RWeick/Gameboy-Demo-Kiosk-DemoBoy-II-/Pics and Documentation/Gameboy Mainboard Connections.jpg

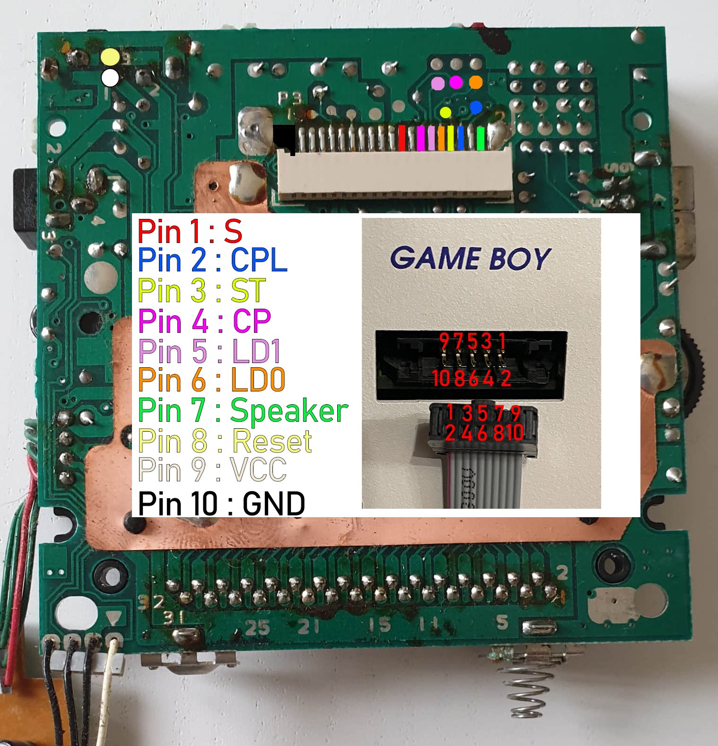
Pics and Documentation/Gameboy Mainboard Connections.jpg
