RWeick/Gameboy-Demo-Kiosk-DemoBoy-II-/Pics and Documentation/Demo_BoyII_Manual.JPG

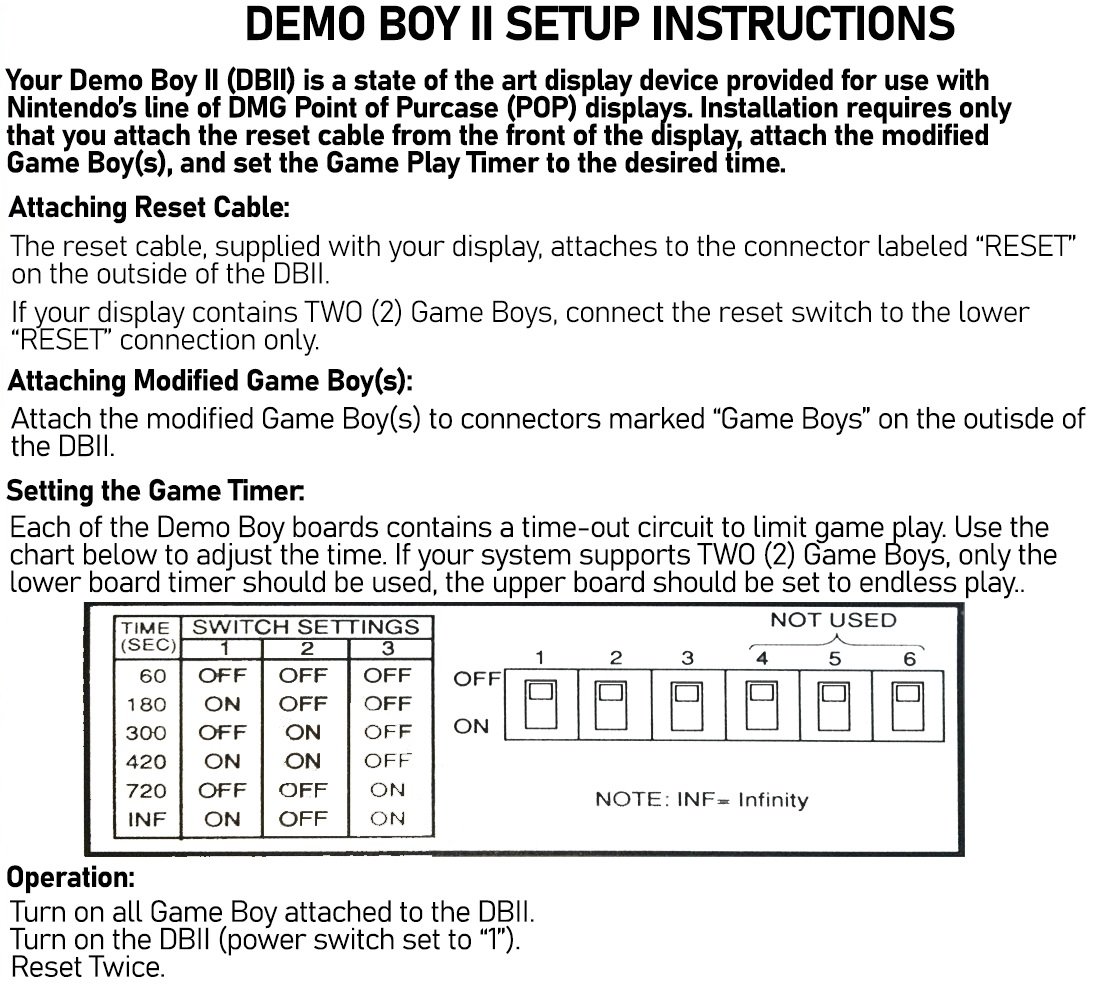
Pics and Documentation/Demo_BoyII_Manual.JPG
