RWeick/Gameboy-Demo-Kiosk-DemoBoy-II-/DemoBoy.kicad_sch

## KiCad design DemoBoy.kicad_sch (2025-12-26)

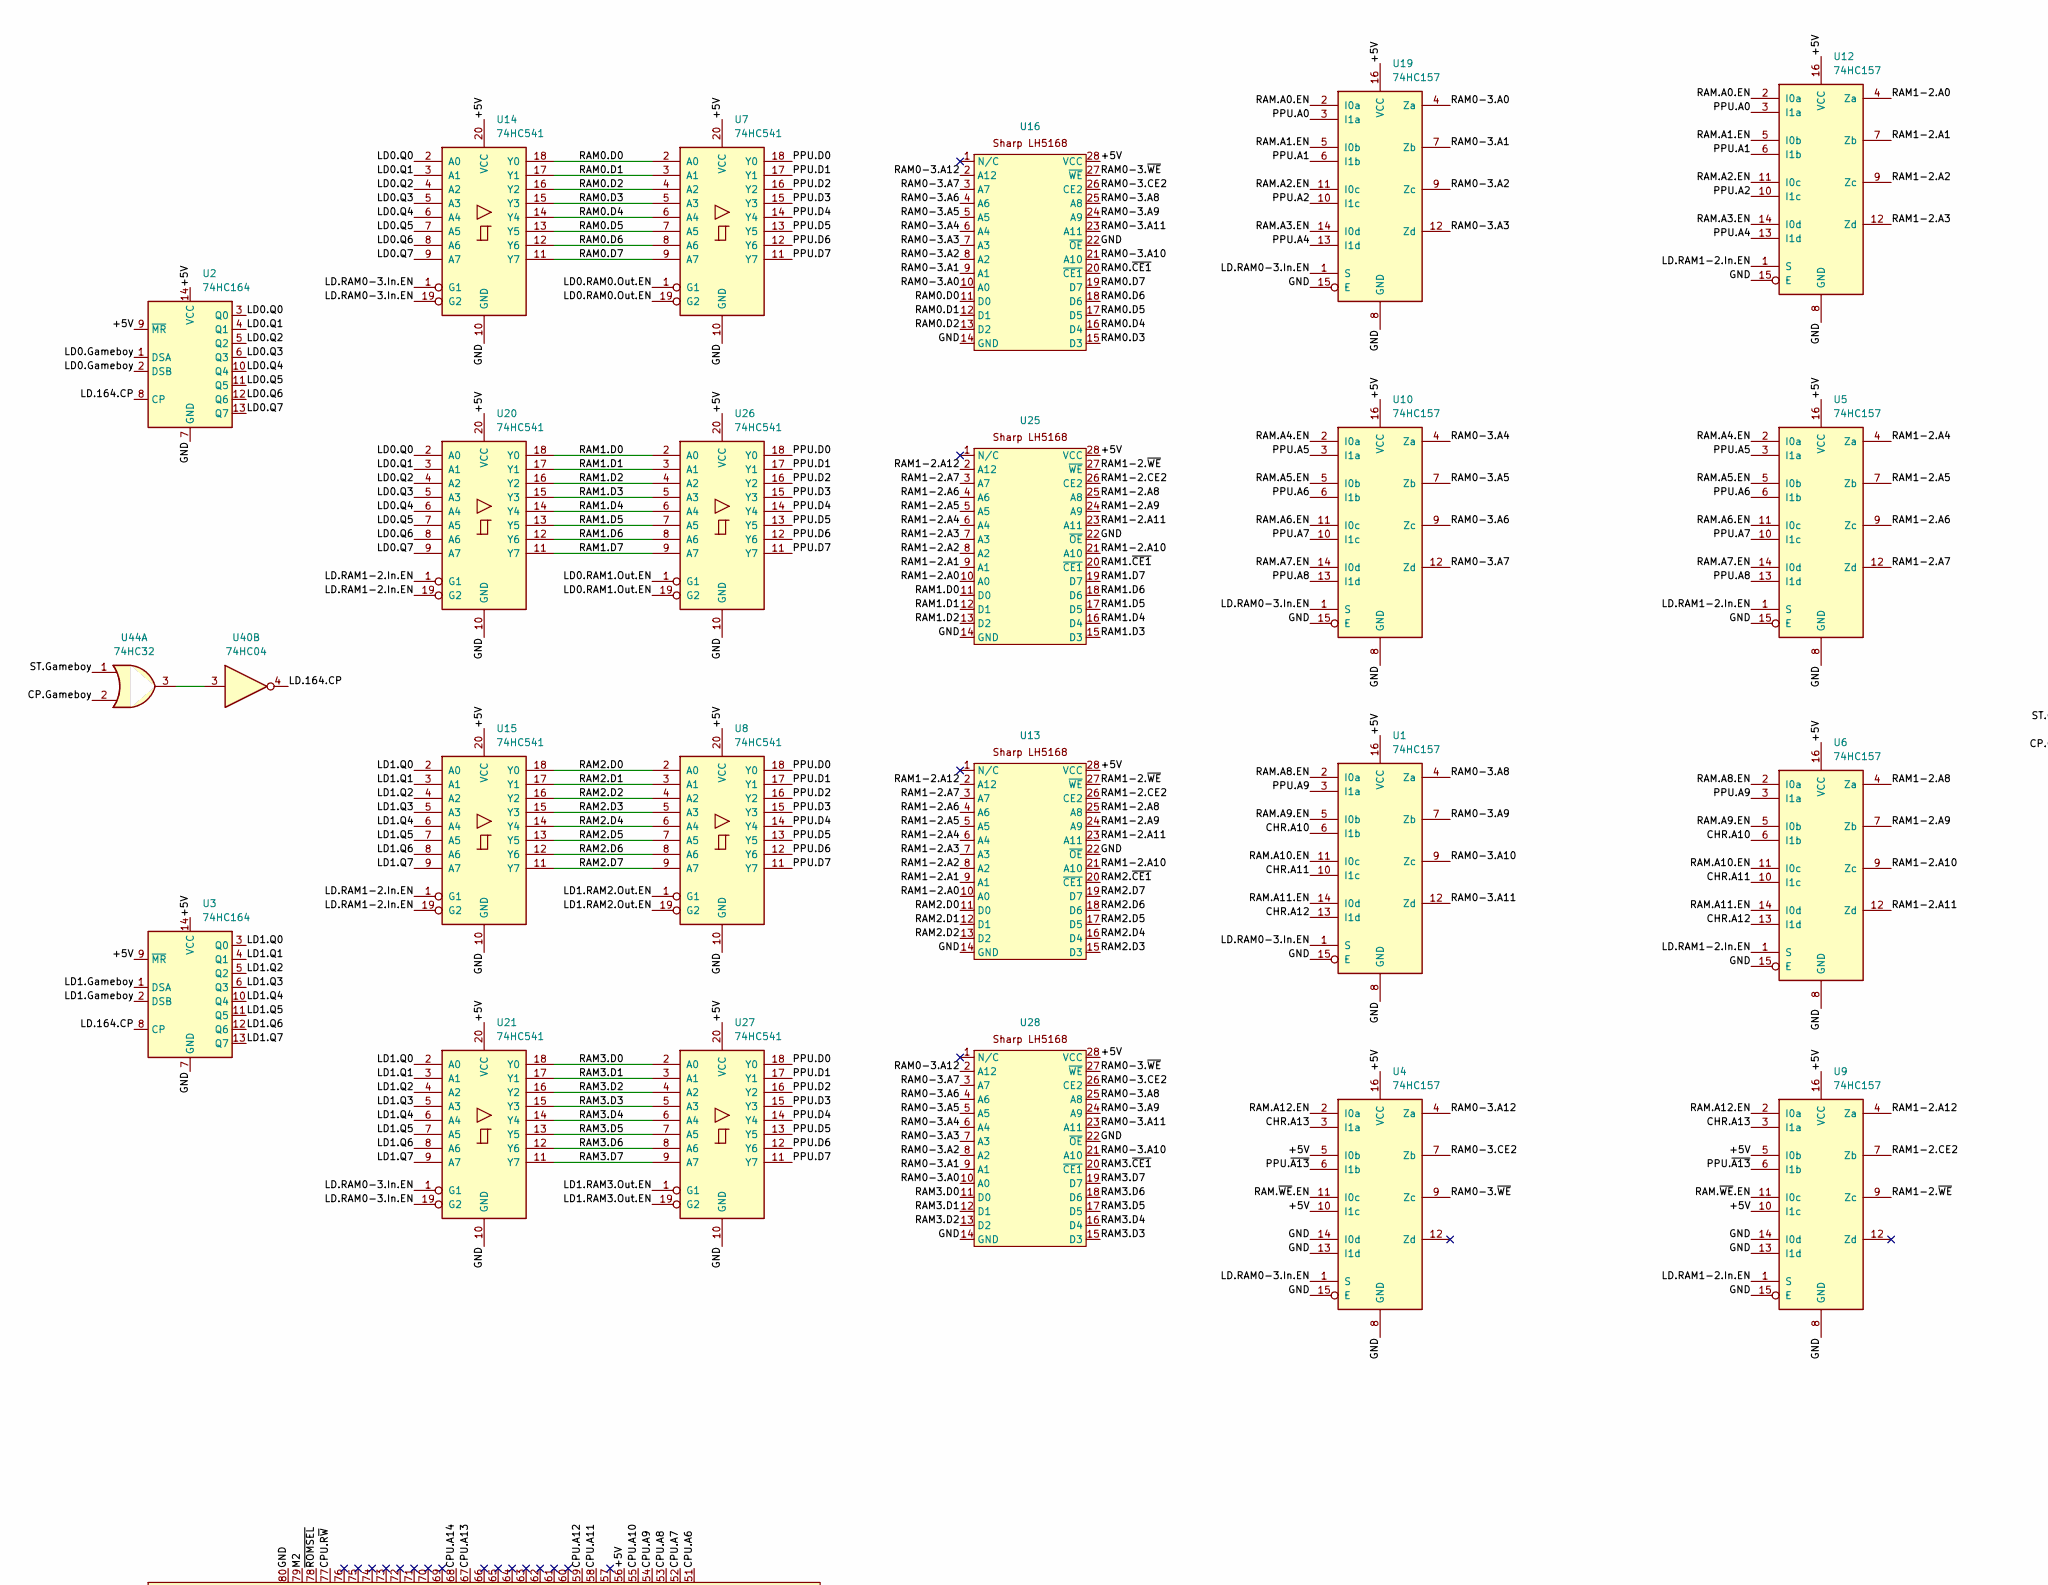
[picture p4: schematic DemoBoy.kicad_sch, part in row 1, column 1]

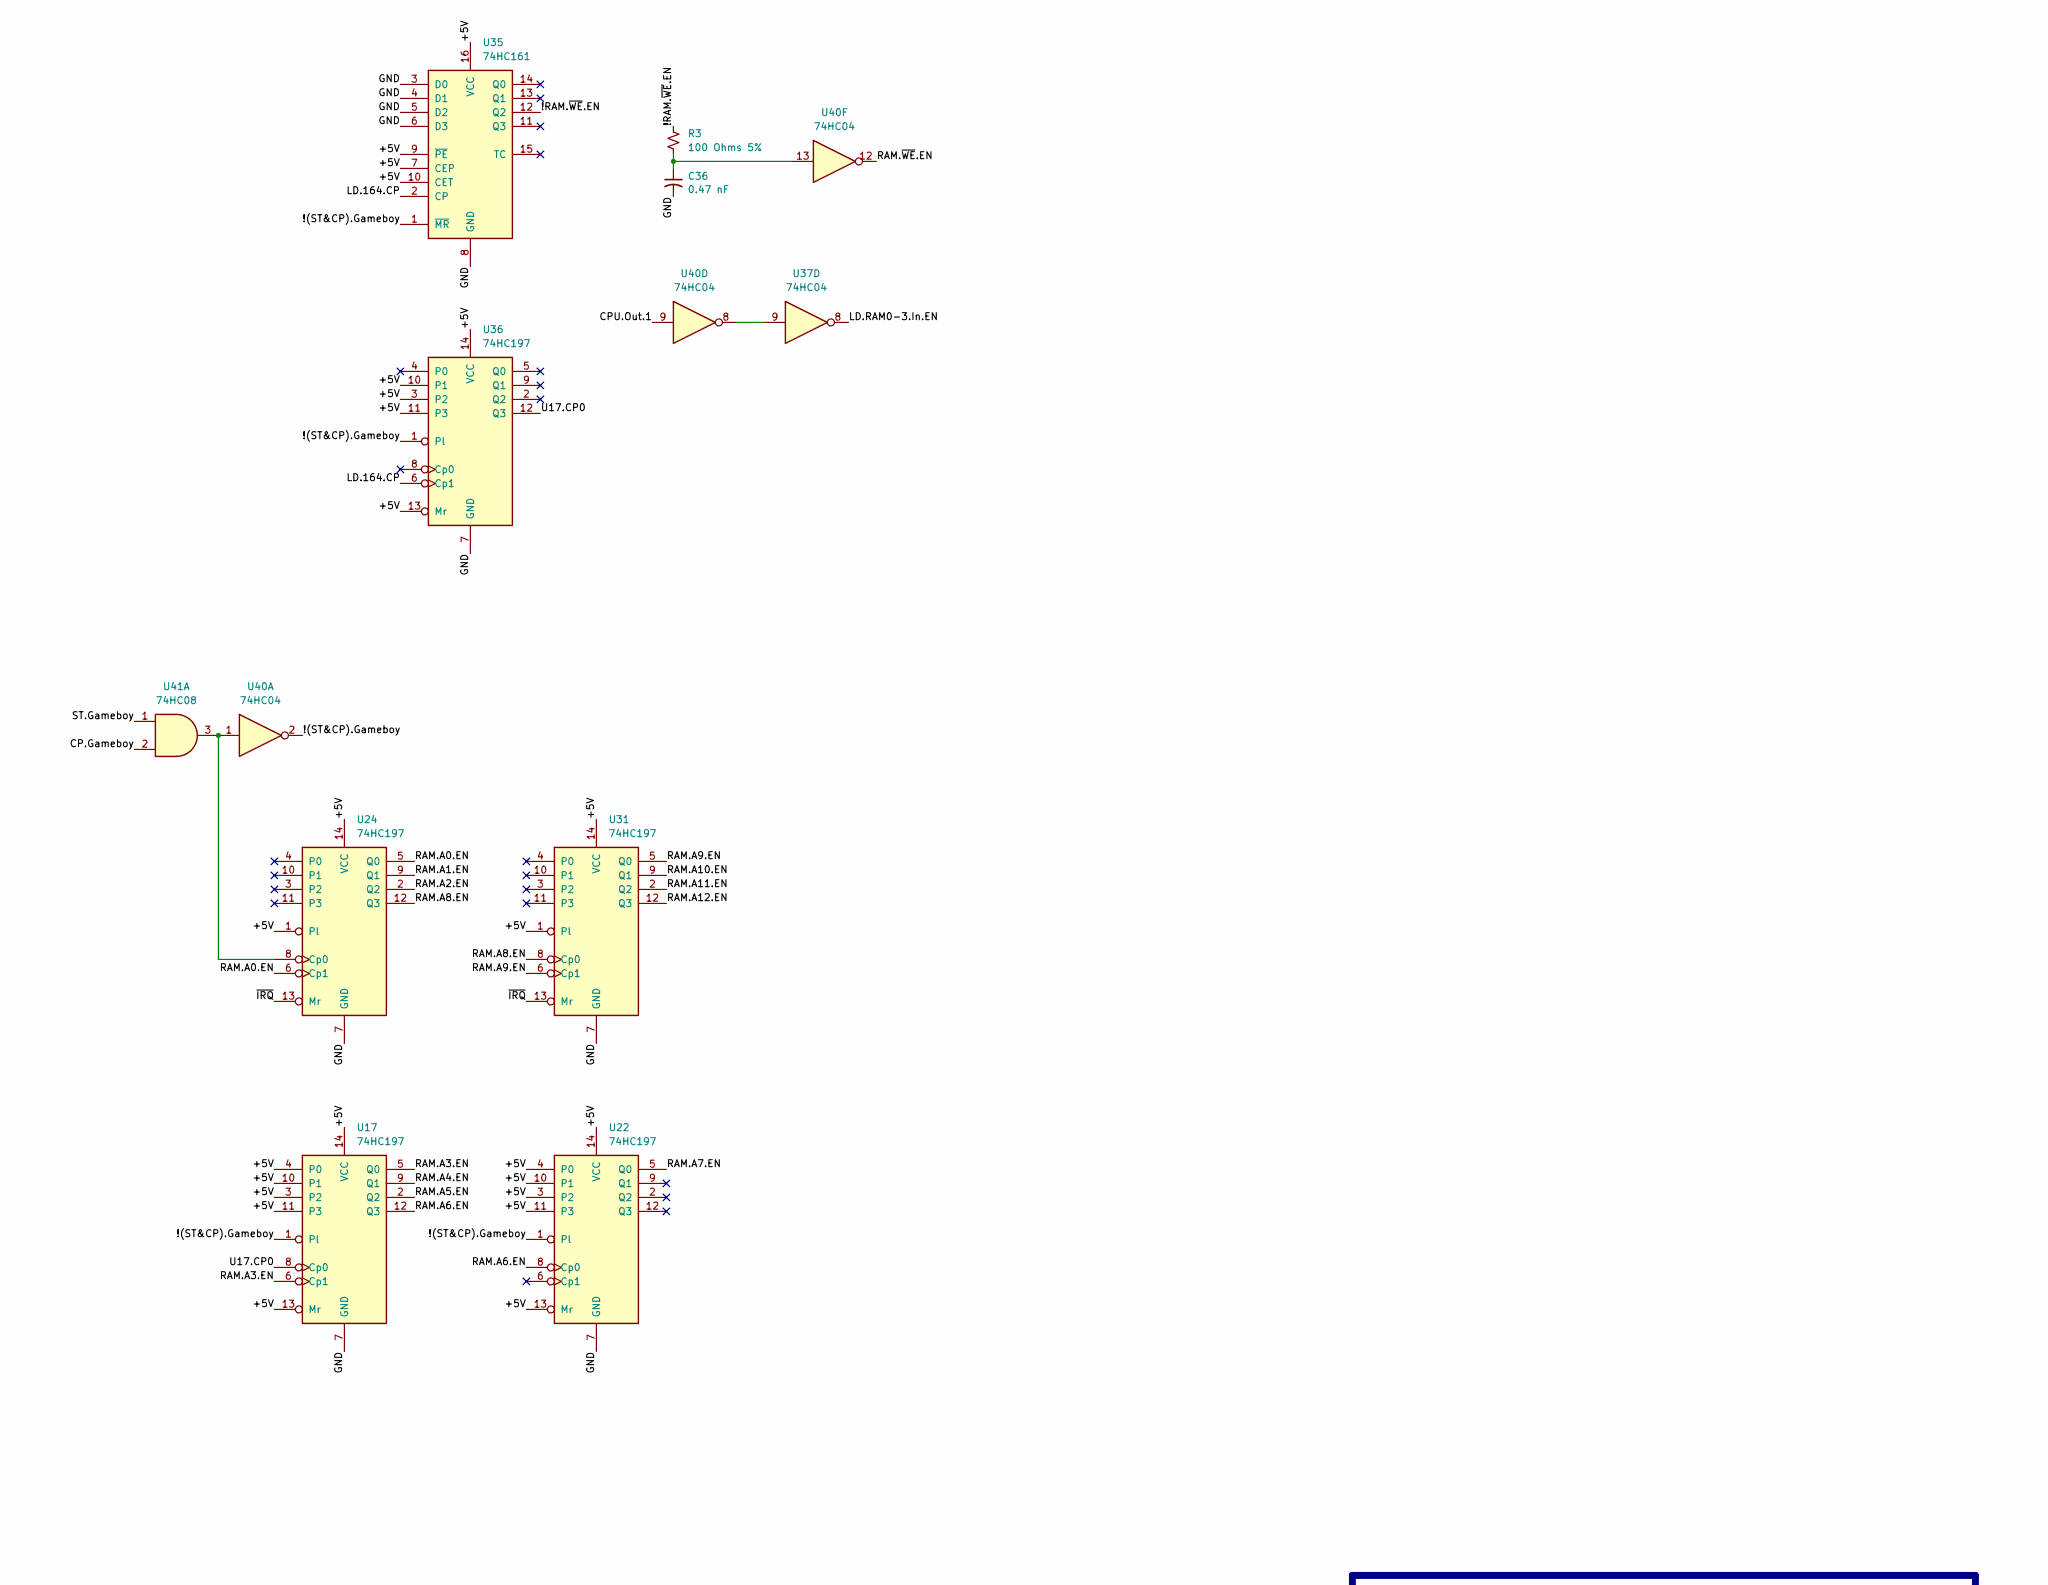
[picture p5: schematic DemoBoy.kicad_sch, part in row 1, column 2]

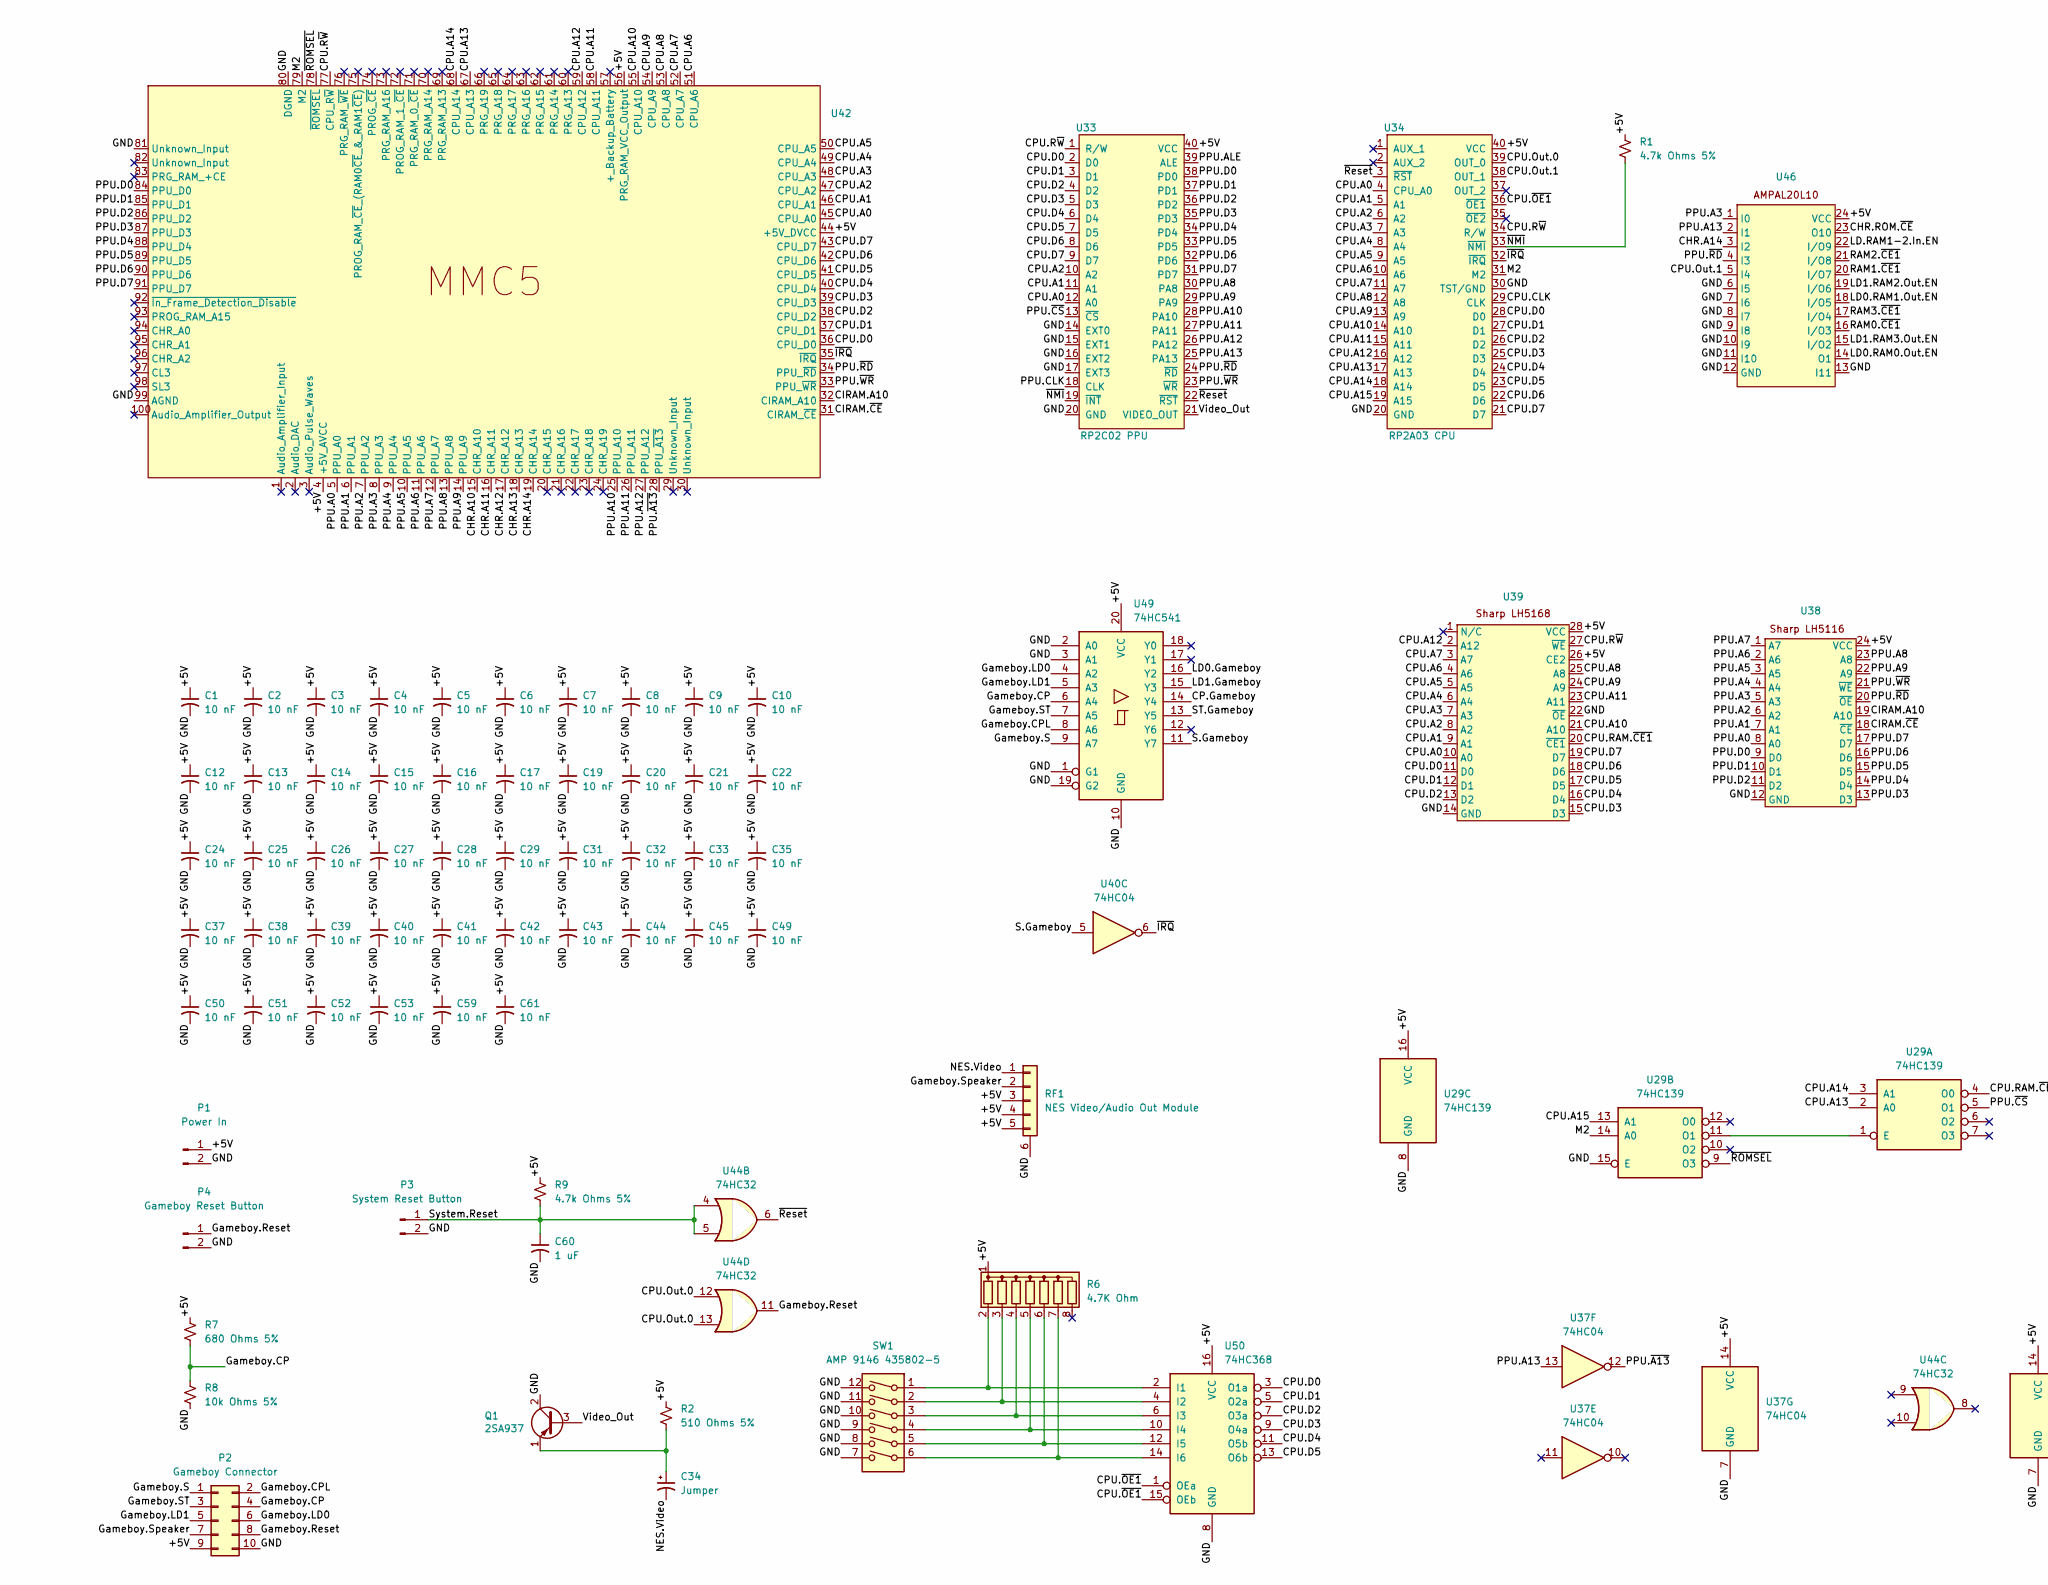
[picture p6: schematic DemoBoy.kicad_sch, part in row 2, column 1]

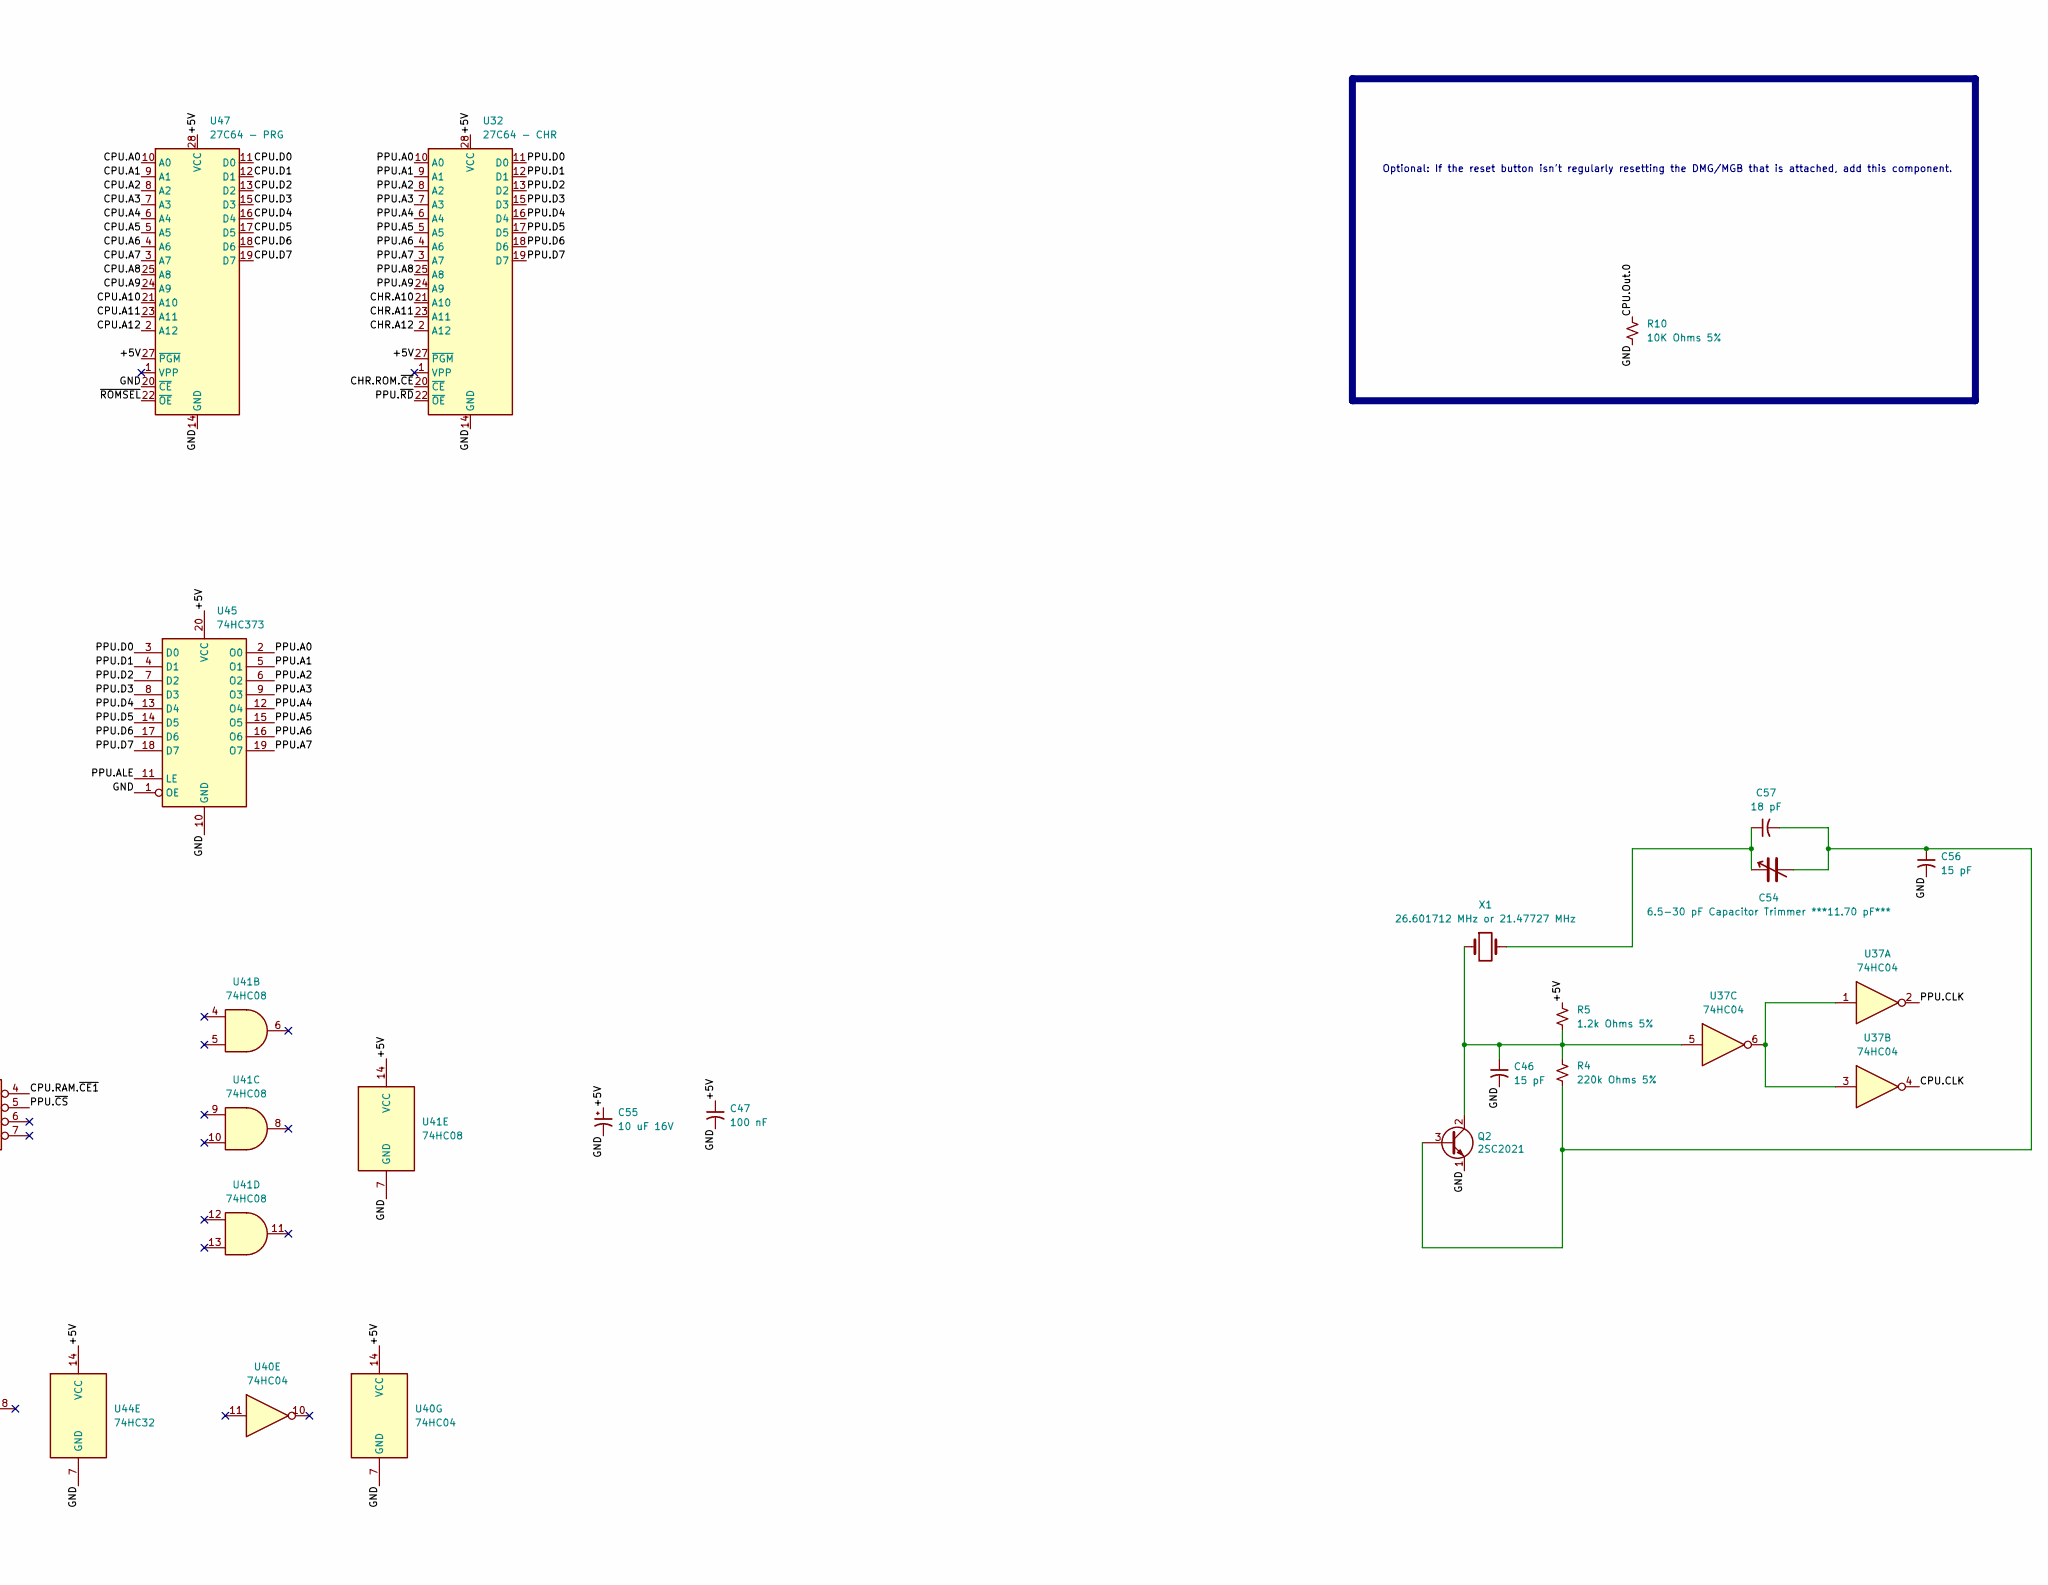
[picture p7: schematic DemoBoy.kicad_sch, part in row 2, column 2]

Parts:
C1, C2, C3, C4, C5, C6, C7, C8, C9, C10, C12, C13, C14, C15, C16, C17, C19, C20, C21, C22, C24, C25, C26, C27, C28, C29, C31, C32, C33, C35, C37, C38, C39, C40, C41, C42, C43, C44, C45, C49, C50, C51, C52, C53, C59, C61: 10 nF; Small Cap
C34: Jumper; CP_Radial_D6.3mm_P2.50mm
C36: 0.47 nF; Large Cap
C46, C56: 15 pF; Large Cap
C47: 100 nF; Large Cap
C54: 6.5-30 pF Capacitor Trimmer ***11.70 pF***; Variable Cap
C55: 10 uF 16V; CP_Radial_D6.3mm_P2.50mm
C57: 18 pF; Large Cap
C60: 1 uF; Large Cap
P1: Power In; Molex
P2: Gameboy Connector; Horizontal Gameboy Connector
P3: System Reset Button; Molex
P4: Gameboy Reset Button; Molex
Q1: 2SA937; Transistor
Q2: 2SC2021; Transistor
R1, R9: 4.7k Ohms 5%; R_Axial_DIN0207_L6.3mm_D2.5mm_P10.16mm_Horizontal
R2: 510 Ohms 5%; R_Axial_DIN0207_L6.3mm_D2.5mm_P10.16mm_Horizontal
R3: 100 Ohms 5%; R_Axial_DIN0207_L6.3mm_D2.5mm_P10.16mm_Horizontal
R4: 220k Ohms 5%; R_Axial_DIN0207_L6.3mm_D2.5mm_P10.16mm_Horizontal
R5: 1.2k Ohms 5%; R_Axial_DIN0207_L6.3mm_D2.5mm_P10.16mm_Horizontal
R6: 4.7K Ohm; R_Array_SIP8
R7: 680 Ohms 5%; R_Axial_DIN0207_L6.3mm_D2.5mm_P10.16mm_Horizontal
R8: 10k Ohms 5%; R_Axial_DIN0207_L6.3mm_D2.5mm_P10.16mm_Horizontal
R10: 10K Ohms 5%; R_Axial_DIN0207_L6.3mm_D2.5mm_P10.16mm_Horizontal
RF1: NES Video/Audio Out Module; Mod_RF
SW1: AMP 9146 435802-5; SW_DIP_SPSTx06_Piano_CTS_Series194-6MSTN_W7.62mm_P2.54mm
U1, U4, U5, U6, U9, U10, U12, U19: 74HC157; DIP-16_W7.62mm
U2, U3: 74HC164; DIP-14_W7.62mm
U7, U8, U14, U15, U20, U21, U26, U27, U49: 74HC541; DIP-20_W7.62mm
U13, U16, U25, U28, U39: DIP-28_W15.24mm
U17, U22, U24, U31, U36: 74HC197; DIP-14_W7.62mm
U29: 74HC139; DIP-16_W7.62mm
U32: 27C64 - CHR; DIP-28_W15.24mm
U33: RP2C02 PPU; DIP-40_W15.24mm
U34: RP2A03 CPU; DIP-40_W15.24mm
U35: 74HC161; DIP-16_W7.62mm
U37, U40: 74HC04; DIP-14_W7.62mm
U38: DIP-24_W15.24mm
U41: 74HC08; DIP-14_W7.62mm
U42: QFP-100_20x14_Pitch0.65mm
U44: 74HC32; DIP-14_W7.62mm
U45: 74HC373; DIP-20_W7.62mm
U46: DIP-24_W7.62mm
U47: 27C64 - PRG; DIP-28_W15.24mm
U50: 74HC368; DIP-16_W7.62mm
X1: 26.601712 MHz or 21.47727 MHz; Crystal

Connections:
!(ST&CP).Gameboy: U17.1 (Pl), U22.1 (Pl), U35.1 (~MR), U36.1 (Pl), U40.2
!RAM.~WE.EN: R3.1, U35.12 (Q2)
+5V: C1.1, C2.1, C3.1, C4.1, C5.1, C6.1, C7.1, C8.1, C9.1, C10.1, C12.1, C13.1, C14.1, C15.1, C16.1, C17.1, C19.1, C20.1, C21.1, C22.1, C24.1, C25.1, C26.1, C27.1, C28.1, C29.1, C31.1, C32.1, C33.1, C35.1, C37.1, C38.1, C39.1, C40.1, C41.1, C42.1, C43.1, C44.1, C45.1, C47.1, C49.1, C50.1, C51.1, C52.1, C53.1, C55.1, C59.1, C61.1, P1.1, P2.9, R1.1, R2.1, R5.1, R6.1 (common), R7.1, R9.1, RF1.3, RF1.4, RF1.5, U1.16 (VCC), U2.9 (~MR), U2.14 (VCC), U3.9 (~MR), U3.14 (VCC), U4.5 (I0b), U4.10 (I1c), U4.16 (VCC), U5.16 (VCC), U6.16 (VCC), U7.20 (VCC), U8.20 (VCC), U9.5 (I0b), U9.10 (I1c), U9.16 (VCC), U10.16 (VCC), U12.16 (VCC), U13.28 (VCC), U14.20 (VCC), U15.20 (VCC), U16.28 (VCC), U17.3 (P2), U17.4 (P0), U17.10 (P1), U17.11 (P3), U17.13 (Mr), U17.14 (VCC), U19.16 (VCC), U20.20 (VCC), U21.20 (VCC), U22.3 (P2), U22.4 (P0), U22.10 (P1), U22.11 (P3), U22.13 (Mr), U22.14 (VCC), U24.1 (Pl), U24.14 (VCC), U25.28 (VCC), U26.20 (VCC), U27.20 (VCC), U28.28 (VCC), U29.16 (VCC), U31.1 (Pl), U31.14 (VCC), U32.27 (~PGM), U32.28 (VCC), U33.40 (VCC), U34.40 (VCC), U35.7 (CEP), U35.9 (~PE), U35.10 (CET), U35.16 (VCC), U36.3 (P2), U36.10 (P1), U36.11 (P3), U36.13 (Mr), U36.14 (VCC), U37.14 (VCC), U38.24 (VCC), U39.26 (CE2), U39.28 (VCC), U40.14 (VCC), U41.14 (VCC), U42.4 (+5V_AVCC), U42.44 (+5V_DVCC), U42.56 (PRG_RAM_VCC_Output), U44.14 (VCC), U45.20 (VCC), U46.24 (VCC), U47.27 (~PGM), U47.28 (VCC), U49.20 (VCC), U50.16 (VCC)
CHR.A10: U1.6 (I1b), U6.6 (I1b), U32.21 (A10), U42.15 (CHR_A10)
CHR.A11: U1.10 (I1c), U6.10 (I1c), U32.23 (A11), U42.16 (CHR_A11)
CHR.A12: U1.13 (I1d), U6.13 (I1d), U32.2 (A12), U42.17 (CHR_A12)
CHR.A13: U4.3 (I1a), U9.3 (I1a), U42.18 (CHR_A13)
CHR.A14: U42.19 (CHR_A14), U46.3 (I2)
CHR.ROM.~CE: U32.20 (~CE), U46.23 (O10)
CIRAM.A10: U38.19 (A10), U42.32 (CIRAM_A10)
CIRAM.~CE: U38.18 (~CE), U42.31 (CIRAM_~CE)
CP.Gameboy: U41.2, U44.2, U49.14 (Y4)
CPU.A0: U33.12 (A0), U34.4 (CPU_A0), U39.10 (A0), U42.45 (CPU_A0), U47.10 (A0)
CPU.A1: U33.11 (A1), U34.5 (A1), U39.9 (A1), U42.46 (CPU_A1), U47.9 (A1)
CPU.A2: U33.10 (A2), U34.6 (A2), U39.8 (A2), U42.47 (CPU_A2), U47.8 (A2)
CPU.A3: U34.7 (A3), U39.7 (A3), U42.48 (CPU_A3), U47.7 (A3)
CPU.A4: U34.8 (A4), U39.6 (A4), U42.49 (CPU_A4), U47.6 (A4)
CPU.A5: U34.9 (A5), U39.5 (A5), U42.50 (CPU_A5), U47.5 (A5)
CPU.A6: U34.10 (A6), U39.4 (A6), U42.51 (CPU_A6), U47.4 (A6)
CPU.A7: U34.11 (A7), U39.3 (A7), U42.52 (CPU_A7), U47.3 (A7)
CPU.A8: U34.12 (A8), U39.25 (A8), U42.53 (CPU_A8), U47.25 (A8)
CPU.A9: U34.13 (A9), U39.24 (A9), U42.54 (CPU_A9), U47.24 (A9)
CPU.A10: U34.14 (A10), U39.21 (A10), U42.55 (CPU_A10), U47.21 (A10)
CPU.A11: U34.15 (A11), U39.23 (A11), U42.58 (CPU_A11), U47.23 (A11)
CPU.A12: U34.16 (A12), U39.2 (A12), U42.59 (CPU_A12), U47.2 (A12)
CPU.A13: U29.2 (A0), U34.17 (A13), U42.67 (CPU_A13)
CPU.A14: U29.3 (A1), U34.18 (A14), U42.68 (CPU_A14)
CPU.A15: U29.13 (A1), U34.19 (A15)
CPU.CLK: U34.29 (CLK), U37.4
CPU.D0: U33.2 (D0), U34.28 (D0), U39.11 (D0), U42.36 (CPU_D0), U47.11 (D0), U50.3 (O1a)
CPU.D1: U33.3 (D1), U34.27 (D1), U39.12 (D1), U42.37 (CPU_D1), U47.12 (D1), U50.5 (O2a)
CPU.D2: U33.4 (D2), U34.26 (D2), U39.13 (D2), U42.38 (CPU_D2), U47.13 (D2), U50.7 (O3a)
CPU.D3: U33.5 (D3), U34.25 (D3), U39.15 (D3), U42.39 (CPU_D3), U47.15 (D3), U50.9 (O4a)
CPU.D4: U33.6 (D4), U34.24 (D4), U39.16 (D4), U42.40 (CPU_D4), U47.16 (D4), U50.11 (O5b)
CPU.D5: U33.7 (D5), U34.23 (D5), U39.17 (D5), U42.41 (CPU_D5), U47.17 (D5), U50.13 (O6b)
CPU.D6: U33.8 (D6), U34.22 (D6), U39.18 (D6), U42.42 (CPU_D6), U47.18 (D6)
CPU.D7: U33.9 (D7), U34.21 (D7), U39.19 (D7), U42.43 (CPU_D7), U47.19 (D7)
CPU.Out.0: R10.1, U34.39 (OUT_0), U44.12, U44.13
CPU.Out.1: U34.38 (OUT_1), U40.9, U46.5 (I4)
CPU.RAM.~CE1: U29.4 (O0), U39.20 (~CE1)
CPU.R~W: U33.1 (R/W), U34.34 (R/W), U39.27 (~WE), U42.77 (CPU_R~W)
CPU.~OE1: U34.36 (~OE1), U50.1 (OEa), U50.15 (OEb)
GND: C1.2, C2.2, C3.2, C4.2, C5.2, C6.2, C7.2, C8.2, C9.2, C10.2, C12.2, C13.2, C14.2, C15.2, C16.2, C17.2, C19.2, C20.2, C21.2, C22.2, C24.2, C25.2, C26.2, C27.2, C28.2, C29.2, C31.2, C32.2, C33.2, C35.2, C36.2, C37.2, C38.2, C39.2, C40.2, C41.2, C42.2, C43.2, C44.2, C45.2, C46.2, C47.2, C49.2, C50.2, C51.2, C52.2, C53.2, C55.2, C56.2, C59.2, C60.2, C61.2, P1.2, P2.10, P3.2, P4.2, Q1.2 (C), Q2.1 (E), R8.2, R10.2, RF1.6 (Pin_5), SW1.7, SW1.8, SW1.9, SW1.10, SW1.11, SW1.12, U1.8 (GND), U1.15 (E), U2.7 (GND), U3.7 (GND), U4.8 (GND), U4.13 (I1d), U4.14 (I0d), U4.15 (E), U5.8 (GND), U5.15 (E), U6.8 (GND), U6.15 (E), U7.10 (GND), U8.10 (GND), U9.8 (GND), U9.13 (I1d), U9.14 (I0d), U9.15 (E), U10.8 (GND), U10.15 (E), U12.8 (GND), U12.15 (E), U13.14 (GND), U13.22 (~OE), U14.10 (GND), U15.10 (GND), U16.14 (GND), U16.22 (~OE), U17.7 (GND), U19.8 (GND), U19.15 (E), U20.10 (GND), U21.10 (GND), U22.7 (GND), U24.7 (GND), U25.14 (GND), U25.22 (~OE), U26.10 (GND), U27.10 (GND), U28.14 (GND), U28.22 (~OE), U29.8 (GND), U29.15 (E), U31.7 (GND), U32.14 (GND), U33.14 (EXT0), U33.15 (EXT1), U33.16 (EXT2), U33.17 (EXT3), U33.20 (GND), U34.20 (GND), U34.30 (TST/GND), U35.3 (D0), U35.4 (D1), U35.5 (D2), U35.6 (D3), U35.8 (GND), U36.7 (GND), U37.7 (GND), U38.12 (GND), U39.14 (GND), U39.22 (~OE), U40.7 (GND), U41.7 (GND), U42.80 (DGND), U42.81 (Unknown_Input), U42.99 (AGND), U44.7 (GND), U45.1 (OE), U45.10 (GND), U46.6 (I5), U46.7 (I6), U46.8 (I7), U46.9 (I8), U46.10 (I9), U46.11 (I10), U46.12 (GND), U46.13 (I11), U47.14 (GND), U47.20 (~CE), U49.1 (G1), U49.2 (A0), U49.3 (A1), U49.10 (GND), U49.19 (G2), U50.8 (GND)
Gameboy.CP: P2.4, R7.2, R8.1, U49.6 (A4)
Gameboy.CPL: P2.2, U49.8 (A6)
Gameboy.LD0: P2.6, U49.4 (A2)
Gameboy.LD1: P2.5, U49.5 (A3)
Gameboy.Reset: P2.8, P4.1, U44.11
Gameboy.S: P2.1, U49.9 (A7)
Gameboy.ST: P2.3, U49.7 (A5)
Gameboy.Speaker: P2.7, RF1.2
LD0.Gameboy: U2.1 (DSA), U2.2 (DSB), U49.16 (Y2)
LD0.Q0: U2.3 (Q0), U14.2 (A0), U20.2 (A0)
LD0.Q1: U2.4 (Q1), U14.3 (A1), U20.3 (A1)
LD0.Q2: U2.5 (Q2), U14.4 (A2), U20.4 (A2)
LD0.Q3: U2.6 (Q3), U14.5 (A3), U20.5 (A3)
LD0.Q4: U2.10 (Q4), U14.6 (A4), U20.6 (A4)
LD0.Q5: U2.11 (Q5), U14.7 (A5), U20.7 (A5)
LD0.Q6: U2.12 (Q6), U14.8 (A6), U20.8 (A6)
LD0.Q7: U2.13 (Q7), U14.9 (A7), U20.9 (A7)
LD0.RAM0.Out.EN: U7.1 (G1), U7.19 (G2), U46.14 (O1)
LD0.RAM1.Out.EN: U26.1 (G1), U26.19 (G2), U46.18 (I/O5)
LD1.Gameboy: U3.1 (DSA), U3.2 (DSB), U49.15 (Y3)
LD1.Q0: U3.3 (Q0), U15.2 (A0), U21.2 (A0)
LD1.Q1: U3.4 (Q1), U15.3 (A1), U21.3 (A1)
LD1.Q2: U3.5 (Q2), U15.4 (A2), U21.4 (A2)
LD1.Q3: U3.6 (Q3), U15.5 (A3), U21.5 (A3)
LD1.Q4: U3.10 (Q4), U15.6 (A4), U21.6 (A4)
LD1.Q5: U3.11 (Q5), U15.7 (A5), U21.7 (A5)
LD1.Q6: U3.12 (Q6), U15.8 (A6), U21.8 (A6)
LD1.Q7: U3.13 (Q7), U15.9 (A7), U21.9 (A7)
LD1.RAM2.Out.EN: U8.1 (G1), U8.19 (G2), U46.19 (I/O6)
LD1.RAM3.Out.EN: U27.1 (G1), U27.19 (G2), U46.15 (I/O2)
LD.164.CP: U2.8 (CP), U3.8 (CP), U35.2 (CP), U36.6 (Cp1), U40.4
LD.RAM0-3.In.EN: U1.1 (S), U4.1 (S), U10.1 (S), U14.1 (G1), U14.19 (G2), U19.1 (S), U21.1 (G1), U21.19 (G2), U37.8
LD.RAM1-2.In.EN: U5.1 (S), U6.1 (S), U9.1 (S), U12.1 (S), U15.1 (G1), U15.19 (G2), U20.1 (G1), U20.19 (G2), U46.22 (I/O9)
M2: U29.14 (A0), U34.31 (M2), U42.79 (M2)
NES.Video: C34.2, RF1.1
unnamed: C34.1, Q1.1 (E), R2.2
unnamed: C36.1, R3.2, U40.13
unnamed: C46.1, Q2.2 (C), R4.1, R5.2, U37.5, X1.1
unnamed: C54.1, C57.1, X1.2
unnamed: C54.2, C56.1, C57.2, Q2.3 (B), R4.2
unnamed: R6.2 (R1), SW1.1, U50.2 (I1)
unnamed: R6.3 (R2), SW1.2, U50.4 (I2)
unnamed: R6.4 (R3), SW1.3, U50.6 (I3)
unnamed: R6.5 (R4), SW1.4, U50.10 (I4)
unnamed: R6.6 (R5), SW1.5, U50.12 (I5)
unnamed: R6.7 (R6), SW1.6, U50.14 (I6)
unnamed: U24.8 (Cp0), U40.1, U41.3
unnamed: U29.1 (E), U29.11 (O1)
unnamed: U37.1, U37.3, U37.6
unnamed: U37.9, U40.8
unnamed: U40.3, U44.3
PPU.A0: U12.3 (I1a), U19.3 (I1a), U32.10 (A0), U38.8 (A0), U42.5 (PPU_A0), U45.2 (O0)
PPU.A1: U12.6 (I1b), U19.6 (I1b), U32.9 (A1), U38.7 (A1), U42.6 (PPU_A1), U45.5 (O1)
PPU.A2: U12.10 (I1c), U19.10 (I1c), U32.8 (A2), U38.6 (A2), U42.7 (PPU_A2), U45.6 (O2)
PPU.A3: U32.7 (A3), U38.5 (A3), U42.8 (PPU_A3), U45.9 (O3), U46.1 (I0)
PPU.A4: U12.13 (I1d), U19.13 (I1d), U32.6 (A4), U38.4 (A4), U42.9 (PPU_A4), U45.12 (O4)
PPU.A5: U5.3 (I1a), U10.3 (I1a), U32.5 (A5), U38.3 (A5), U42.10 (PPU_A5), U45.15 (O5)
PPU.A6: U5.6 (I1b), U10.6 (I1b), U32.4 (A6), U38.2 (A6), U42.11 (PPU_A6), U45.16 (O6)
PPU.A7: U5.10 (I1c), U10.10 (I1c), U32.3 (A7), U38.1 (A7), U42.12 (PPU_A7), U45.19 (O7)
PPU.A8: U5.13 (I1d), U10.13 (I1d), U32.25 (A8), U33.30 (PA8), U38.23 (A8), U42.13 (PPU_A8)
PPU.A9: U1.3 (I1a), U6.3 (I1a), U32.24 (A9), U33.29 (PA9), U38.22 (A9), U42.14 (PPU_A9)
PPU.A10: U33.28 (PA10), U42.25 (PPU_A10)
PPU.A11: U33.27 (PA11), U42.26 (PPU_A11)
PPU.A12: U33.26 (PA12), U42.27 (PPU_A12)
PPU.A13: U33.25 (PA13), U37.13, U46.2 (I1)
PPU.ALE: U33.39 (ALE), U45.11 (LE)
PPU.CLK: U33.18 (CLK), U37.2
PPU.D0: U7.18 (Y0), U8.18 (Y0), U26.18 (Y0), U27.18 (Y0), U32.11 (D0), U33.38 (PD0), U38.9 (D0), U42.84 (PPU_D0), U45.3 (D0)
PPU.D1: U7.17 (Y1), U8.17 (Y1), U26.17 (Y1), U27.17 (Y1), U32.12 (D1), U33.37 (PD1), U38.10 (D1), U42.85 (PPU_D1), U45.4 (D1)
PPU.D2: U7.16 (Y2), U8.16 (Y2), U26.16 (Y2), U27.16 (Y2), U32.13 (D2), U33.36 (PD2), U38.11 (D2), U42.86 (PPU_D2), U45.7 (D2)
PPU.D3: U7.15 (Y3), U8.15 (Y3), U26.15 (Y3), U27.15 (Y3), U32.15 (D3), U33.35 (PD3), U38.13 (D3), U42.87 (PPU_D3), U45.8 (D3)
PPU.D4: U7.14 (Y4), U8.14 (Y4), U26.14 (Y4), U27.14 (Y4), U32.16 (D4), U33.34 (PD4), U38.14 (D4), U42.88 (PPU_D4), U45.13 (D4)
PPU.D5: U7.13 (Y5), U8.13 (Y5), U26.13 (Y5), U27.13 (Y5), U32.17 (D5), U33.33 (PD5), U38.15 (D5), U42.89 (PPU_D5), U45.14 (D5)
PPU.D6: U7.12 (Y6), U8.12 (Y6), U26.12 (Y6), U27.12 (Y6), U32.18 (D6), U33.32 (PD6), U38.16 (D6), U42.90 (PPU_D6), U45.17 (D6)
PPU.D7: U7.11 (Y7), U8.11 (Y7), U26.11 (Y7), U27.11 (Y7), U32.19 (D7), U33.31 (PD7), U38.17 (D7), U42.91 (PPU_D7), U45.18 (D7)
PPU.~A13: U4.6 (I1b), U9.6 (I1b), U37.12, U42.28 (PPU_~A13)
PPU.~CS: U29.5 (O1), U33.13 (~CS)
PPU.~RD: U32.22 (~OE), U33.24 (~RD), U38.20 (~OE), U42.34 (PPU_~RD), U46.4 (I3)
PPU.~WR: U33.23 (~WR), U38.21 (~WE), U42.33 (PPU_~WR)
RAM0-3.A0: U16.10 (A0), U19.4 (Za), U28.10 (A0)
RAM0-3.A1: U16.9 (A1), U19.7 (Zb), U28.9 (A1)
RAM0-3.A2: U16.8 (A2), U19.9 (Zc), U28.8 (A2)
RAM0-3.A3: U16.7 (A3), U19.12 (Zd), U28.7 (A3)
RAM0-3.A4: U10.4 (Za), U16.6 (A4), U28.6 (A4)
RAM0-3.A5: U10.7 (Zb), U16.5 (A5), U28.5 (A5)
RAM0-3.A6: U10.9 (Zc), U16.4 (A6), U28.4 (A6)
RAM0-3.A7: U10.12 (Zd), U16.3 (A7), U28.3 (A7)
RAM0-3.A8: U1.4 (Za), U16.25 (A8), U28.25 (A8)
RAM0-3.A9: U1.7 (Zb), U16.24 (A9), U28.24 (A9)
RAM0-3.A10: U1.9 (Zc), U16.21 (A10), U28.21 (A10)
RAM0-3.A11: U1.12 (Zd), U16.23 (A11), U28.23 (A11)
RAM0-3.A12: U4.4 (Za), U16.2 (A12), U28.2 (A12)
RAM0-3.CE2: U4.7 (Zb), U16.26 (CE2), U28.26 (CE2)
RAM0-3.~WE: U4.9 (Zc), U16.27 (~WE), U28.27 (~WE)
RAM0.D0: U7.2 (A0), U14.18 (Y0), U16.11 (D0)
RAM0.D1: U7.3 (A1), U14.17 (Y1), U16.12 (D1)
RAM0.D2: U7.4 (A2), U14.16 (Y2), U16.13 (D2)
RAM0.D3: U7.5 (A3), U14.15 (Y3), U16.15 (D3)
RAM0.D4: U7.6 (A4), U14.14 (Y4), U16.16 (D4)
RAM0.D5: U7.7 (A5), U14.13 (Y5), U16.17 (D5)
RAM0.D6: U7.8 (A6), U14.12 (Y6), U16.18 (D6)
RAM0.D7: U7.9 (A7), U14.11 (Y7), U16.19 (D7)
RAM0.~CE1: U16.20 (~CE1), U46.16 (I/O3)
RAM1-2.A0: U12.4 (Za), U13.10 (A0), U25.10 (A0)
RAM1-2.A1: U12.7 (Zb), U13.9 (A1), U25.9 (A1)
RAM1-2.A2: U12.9 (Zc), U13.8 (A2), U25.8 (A2)
RAM1-2.A3: U12.12 (Zd), U13.7 (A3), U25.7 (A3)
RAM1-2.A4: U5.4 (Za), U13.6 (A4), U25.6 (A4)
RAM1-2.A5: U5.7 (Zb), U13.5 (A5), U25.5 (A5)
RAM1-2.A6: U5.9 (Zc), U13.4 (A6), U25.4 (A6)
RAM1-2.A7: U5.12 (Zd), U13.3 (A7), U25.3 (A7)
RAM1-2.A8: U6.4 (Za), U13.25 (A8), U25.25 (A8)
RAM1-2.A9: U6.7 (Zb), U13.24 (A9), U25.24 (A9)
RAM1-2.A10: U6.9 (Zc), U13.21 (A10), U25.21 (A10)
RAM1-2.A11: U6.12 (Zd), U13.23 (A11), U25.23 (A11)
RAM1-2.A12: U9.4 (Za), U13.2 (A12), U25.2 (A12)
RAM1-2.CE2: U9.7 (Zb), U13.26 (CE2), U25.26 (CE2)
RAM1-2.~WE: U9.9 (Zc), U13.27 (~WE), U25.27 (~WE)
RAM1.D0: U20.18 (Y0), U25.11 (D0), U26.2 (A0)
RAM1.D1: U20.17 (Y1), U25.12 (D1), U26.3 (A1)
RAM1.D2: U20.16 (Y2), U25.13 (D2), U26.4 (A2)
RAM1.D3: U20.15 (Y3), U25.15 (D3), U26.5 (A3)
RAM1.D4: U20.14 (Y4), U25.16 (D4), U26.6 (A4)
RAM1.D5: U20.13 (Y5), U25.17 (D5), U26.7 (A5)
RAM1.D6: U20.12 (Y6), U25.18 (D6), U26.8 (A6)
RAM1.D7: U20.11 (Y7), U25.19 (D7), U26.9 (A7)
RAM1.~CE1: U25.20 (~CE1), U46.20 (I/O7)
RAM2.D0: U8.2 (A0), U13.11 (D0), U15.18 (Y0)
RAM2.D1: U8.3 (A1), U13.12 (D1), U15.17 (Y1)
RAM2.D2: U8.4 (A2), U13.13 (D2), U15.16 (Y2)
RAM2.D3: U8.5 (A3), U13.15 (D3), U15.15 (Y3)
RAM2.D4: U8.6 (A4), U13.16 (D4), U15.14 (Y4)
RAM2.D5: U8.7 (A5), U13.17 (D5), U15.13 (Y5)
RAM2.D6: U8.8 (A6), U13.18 (D6), U15.12 (Y6)
RAM2.D7: U8.9 (A7), U13.19 (D7), U15.11 (Y7)
RAM2.~CE1: U13.20 (~CE1), U46.21 (I/O8)
RAM3.D0: U21.18 (Y0), U27.2 (A0), U28.11 (D0)
RAM3.D1: U21.17 (Y1), U27.3 (A1), U28.12 (D1)
RAM3.D2: U21.16 (Y2), U27.4 (A2), U28.13 (D2)
RAM3.D3: U21.15 (Y3), U27.5 (A3), U28.15 (D3)
RAM3.D4: U21.14 (Y4), U27.6 (A4), U28.16 (D4)
RAM3.D5: U21.13 (Y5), U27.7 (A5), U28.17 (D5)
RAM3.D6: U21.12 (Y6), U27.8 (A6), U28.18 (D6)
RAM3.D7: U21.11 (Y7), U27.9 (A7), U28.19 (D7)
RAM3.~CE1: U28.20 (~CE1), U46.17 (I/O4)
RAM.A0.EN: U12.2 (I0a), U19.2 (I0a), U24.5 (Q0), U24.6 (Cp1)
RAM.A1.EN: U12.5 (I0b), U19.5 (I0b), U24.9 (Q1)
RAM.A2.EN: U12.11 (I0c), U19.11 (I0c), U24.2 (Q2)
RAM.A3.EN: U12.14 (I0d), U17.5 (Q0), U17.6 (Cp1), U19.14 (I0d)
RAM.A4.EN: U5.2 (I0a), U10.2 (I0a), U17.9 (Q1)
RAM.A5.EN: U5.5 (I0b), U10.5 (I0b), U17.2 (Q2)
RAM.A6.EN: U5.11 (I0c), U10.11 (I0c), U17.12 (Q3), U22.8 (Cp0)
RAM.A7.EN: U5.14 (I0d), U10.14 (I0d), U22.5 (Q0)
RAM.A8.EN: U1.2 (I0a), U6.2 (I0a), U24.12 (Q3), U31.8 (Cp0)
RAM.A9.EN: U1.5 (I0b), U6.5 (I0b), U31.5 (Q0), U31.6 (Cp1)
RAM.A10.EN: U1.11 (I0c), U6.11 (I0c), U31.9 (Q1)
RAM.A11.EN: U1.14 (I0d), U6.14 (I0d), U31.2 (Q2)
RAM.A12.EN: U4.2 (I0a), U9.2 (I0a), U31.12 (Q3)
RAM.~WE.EN: U4.11 (I0c), U9.11 (I0c), U40.12
S.Gameboy: U40.5, U49.11 (Y7)
ST.Gameboy: U41.1, U44.1, U49.13 (Y5)
System.Reset: C60.1, P3.1, R9.2, U44.4, U44.5
U17.CP0: U17.8 (Cp0), U36.12 (Q3)
Video_Out: Q1.3 (B), U33.21 (VIDEO_OUT)
~IRQ: U24.13 (Mr), U31.13 (Mr), U34.32 (~IRQ), U40.6, U42.35 (~IRQ)
~NMI: R1.2, U33.19 (~INT), U34.33 (~NMI)
~ROMSEL: U29.9 (O3), U42.78 (~ROMSEL), U47.22 (~OE)
~Reset: U33.22 (~RST), U34.3 (~RST), U44.6

Notes on the sheet:
Optional: If the reset button isn't regularly resetting the DMG/MGB that is attached, add this component.
